ProyectoMultiagentes/openPMA/imagenes/DDMR_bottom.JPG

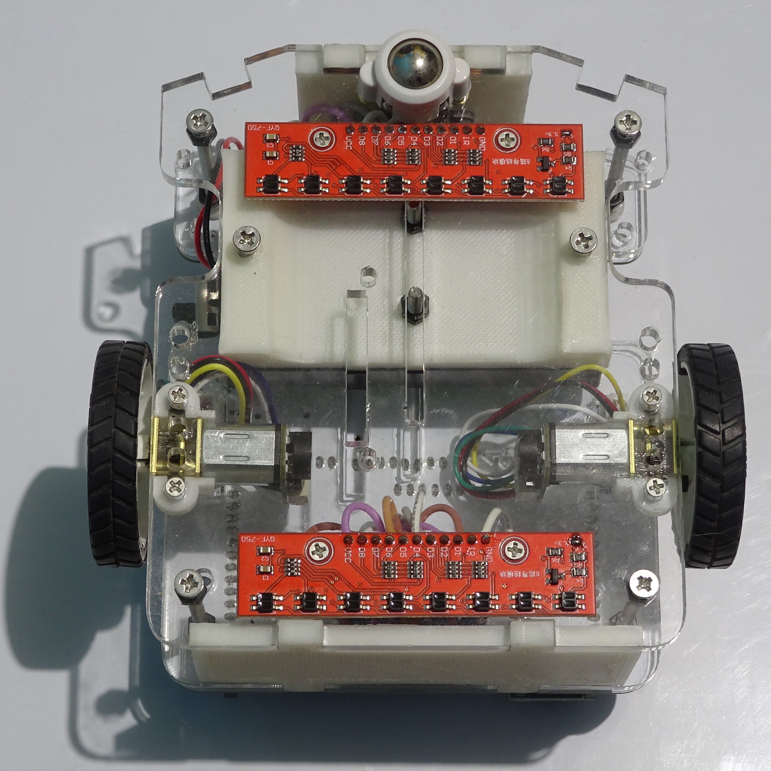
imagenes/DDMR_bottom.JPG
