ProyectoMultiagentes/openPMA/imagenes/DDMR_CAD.png

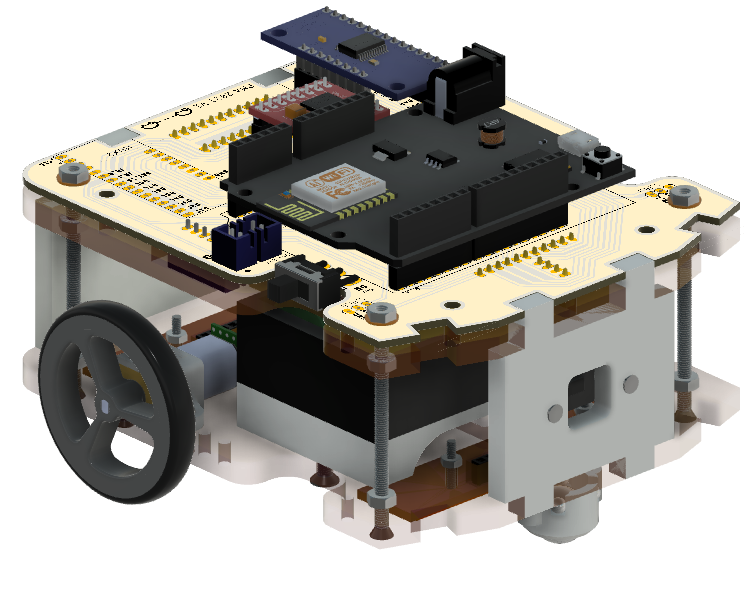
imagenes/DDMR_CAD.png
