ProyectoMultiagentes/openPMA/imagenes/DDMR_top.JPG

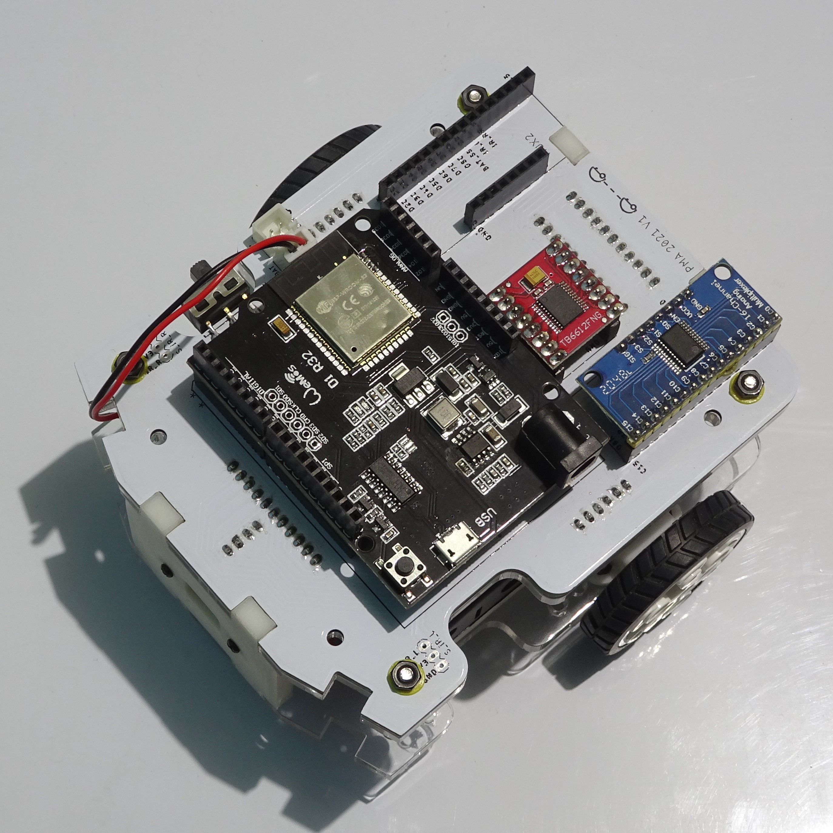
imagenes/DDMR_top.JPG
