ProyectoMultiagentes/openPMA/imagenes/diagrama_de_conexiones_robot.png

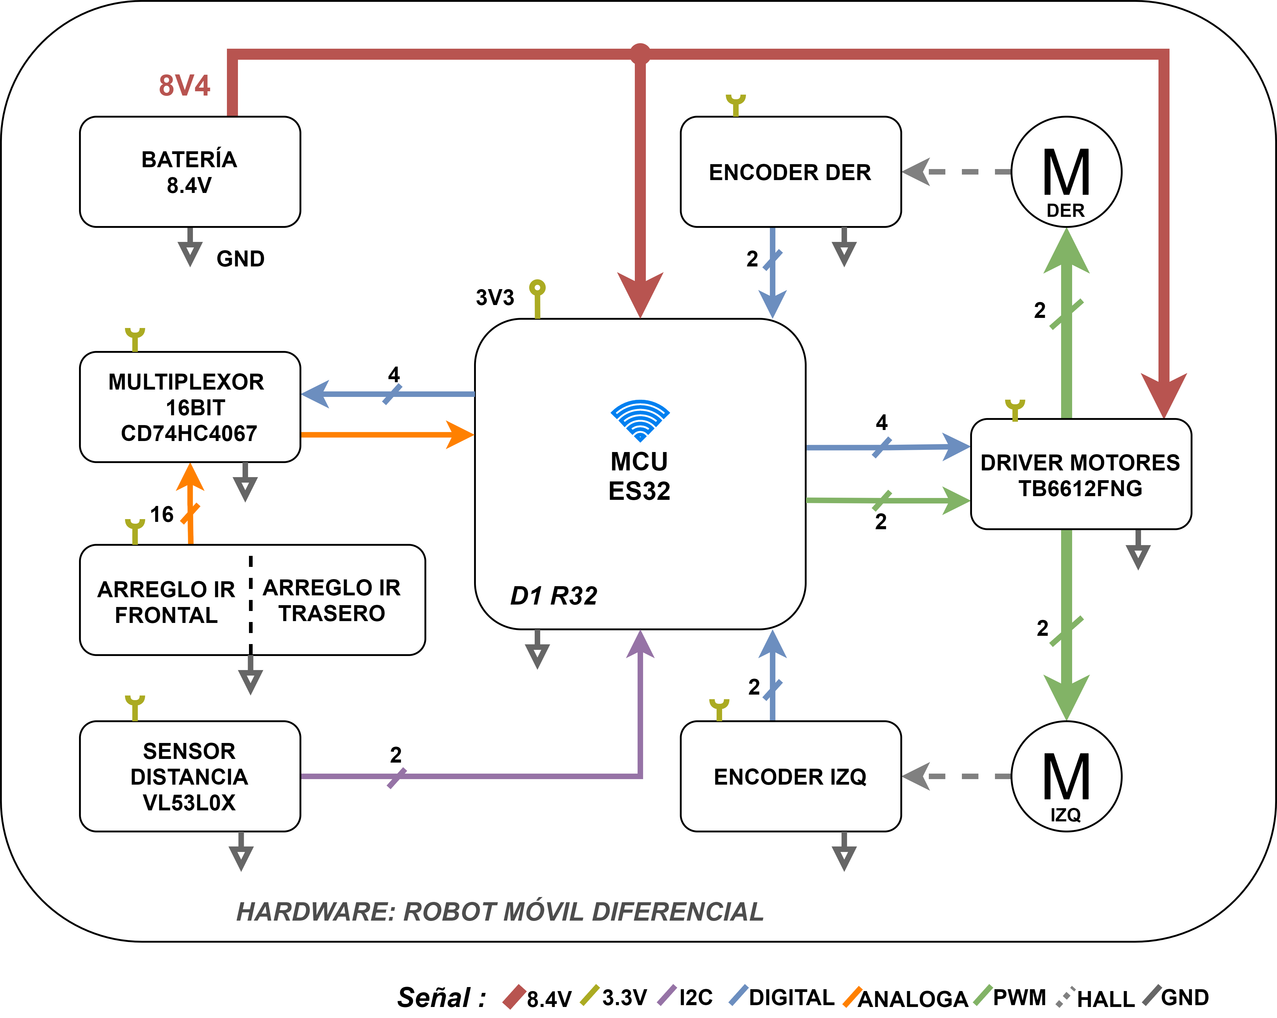
imagenes/diagrama_de_conexiones_robot.png
