ProyectoMultiagentes/openPMA/imagenes/modulos_goma_eva.JPG

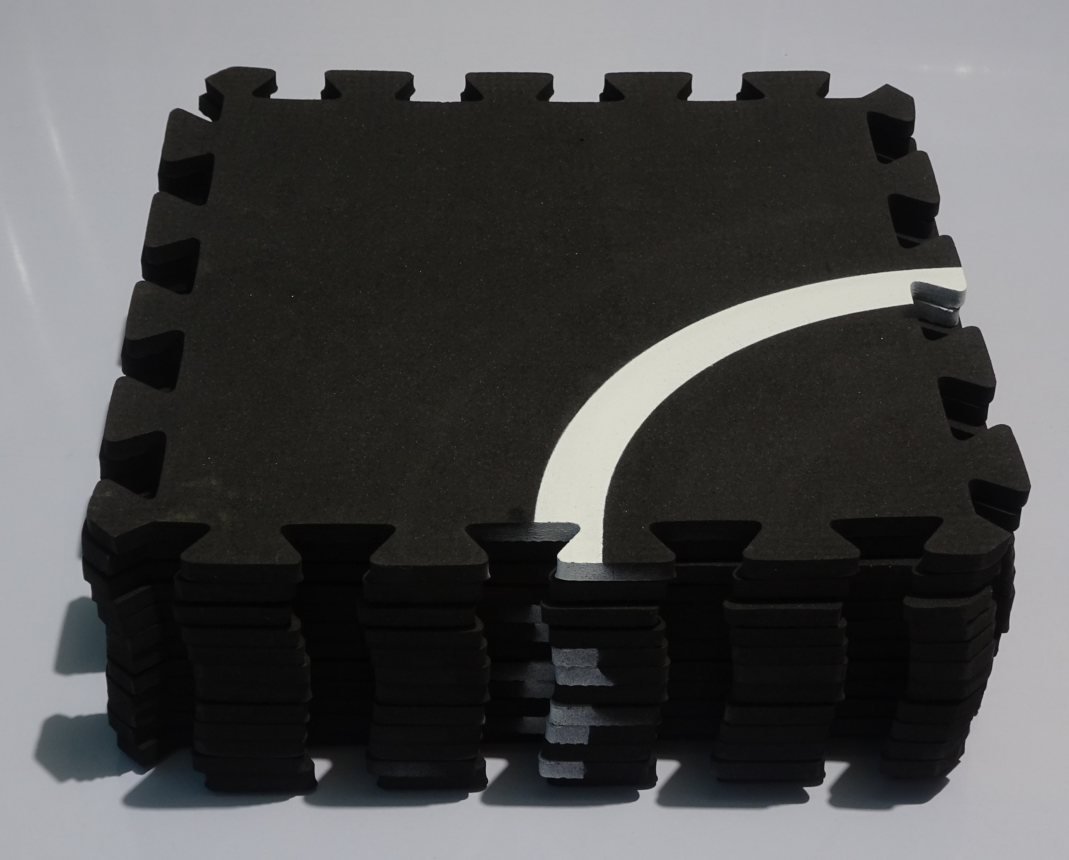
imagenes/modulos_goma_eva.JPG
