ProyectoMultiagentes/openPMA/imagenes/modulos_pista.JPG

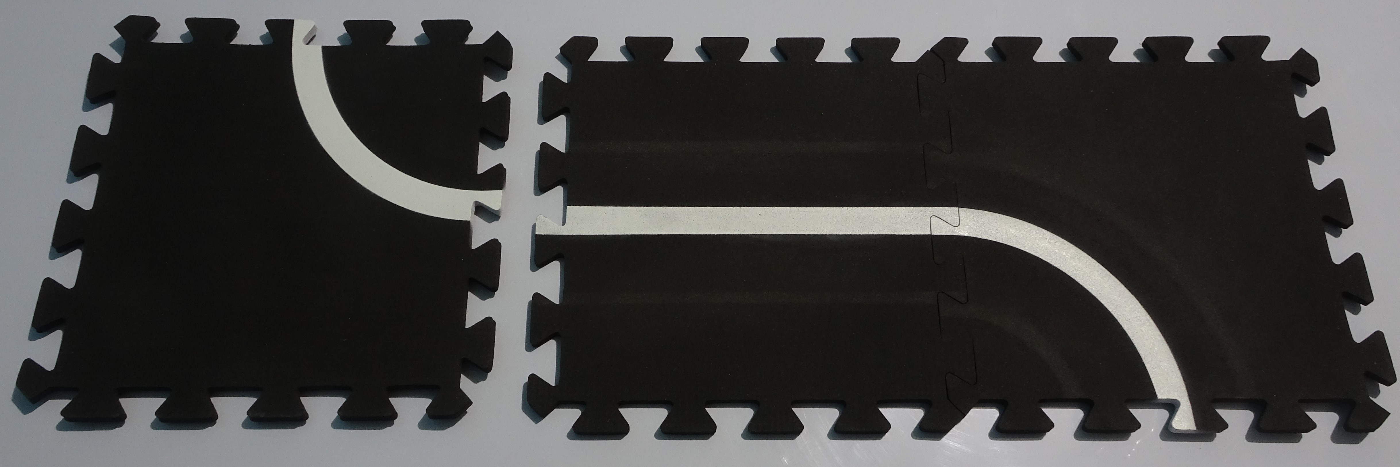
imagenes/modulos_pista.JPG
