ProyectoMultiagentes/openPMA/imagenes/openPMA_topologia_red.png

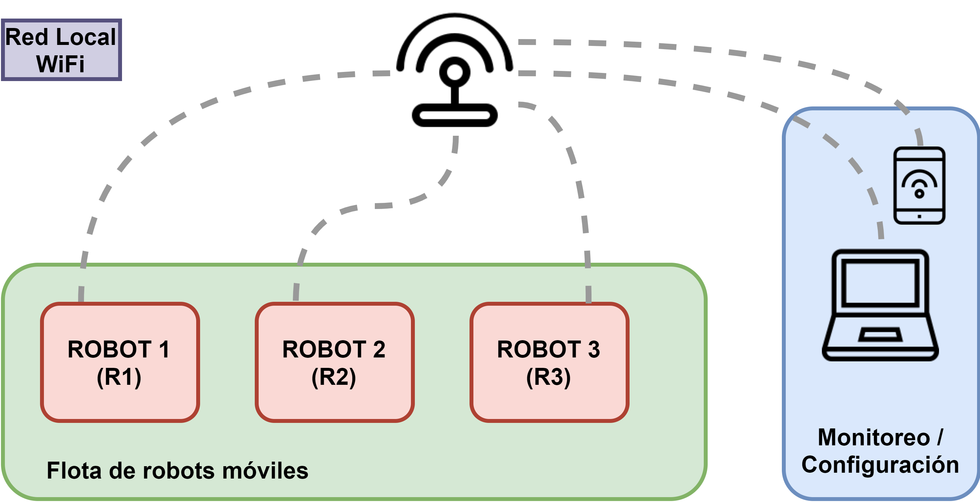
imagenes/openPMA_topologia_red.png
