ProyectoMultiagentes/openPMA/imagenes/PCB_DDMR_bottom.png

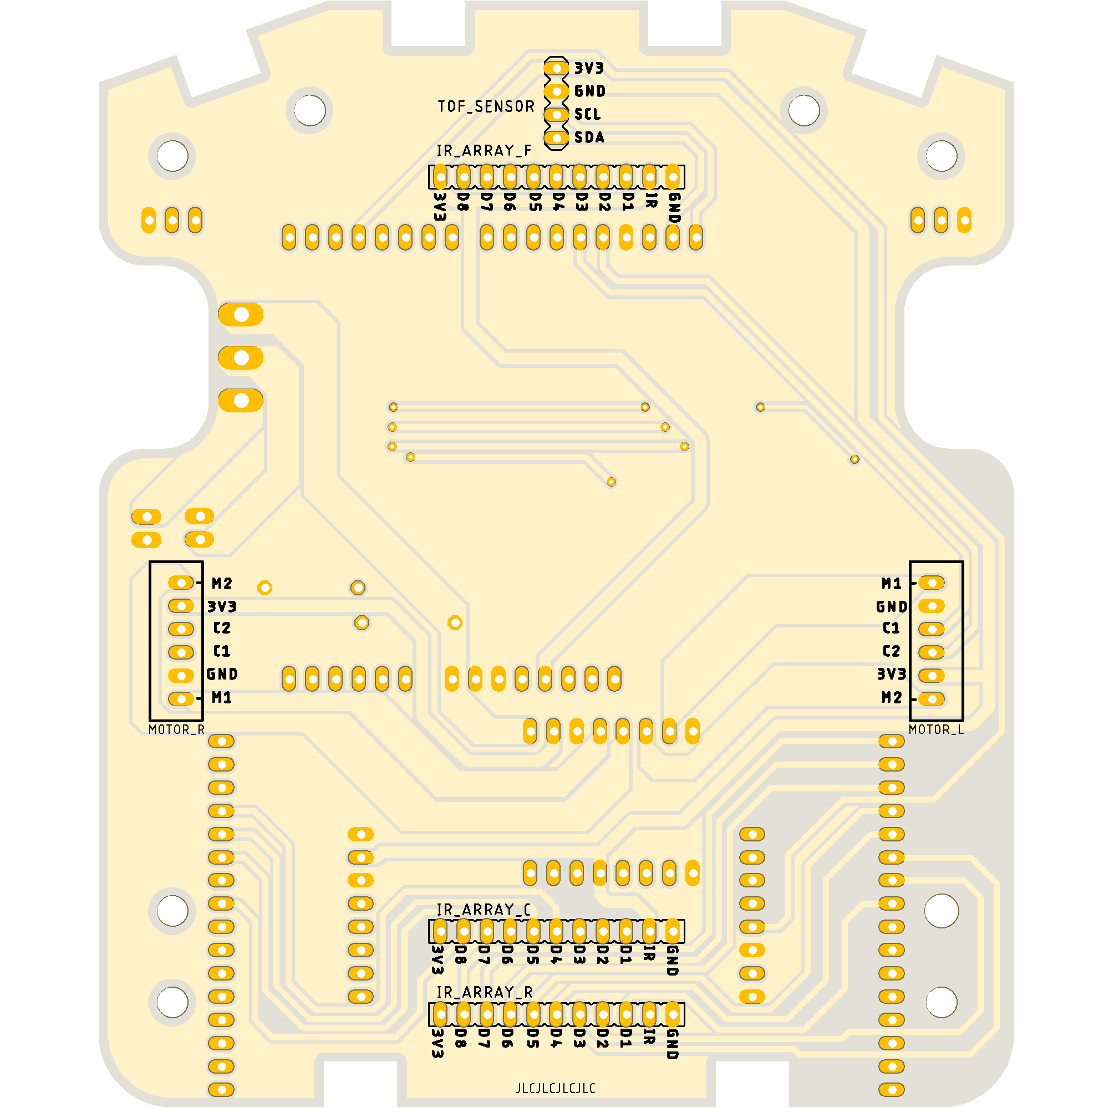
imagenes/PCB_DDMR_bottom.png
