ProyectoMultiagentes/openPMA/imagenes/PCB_DDMR_top.png

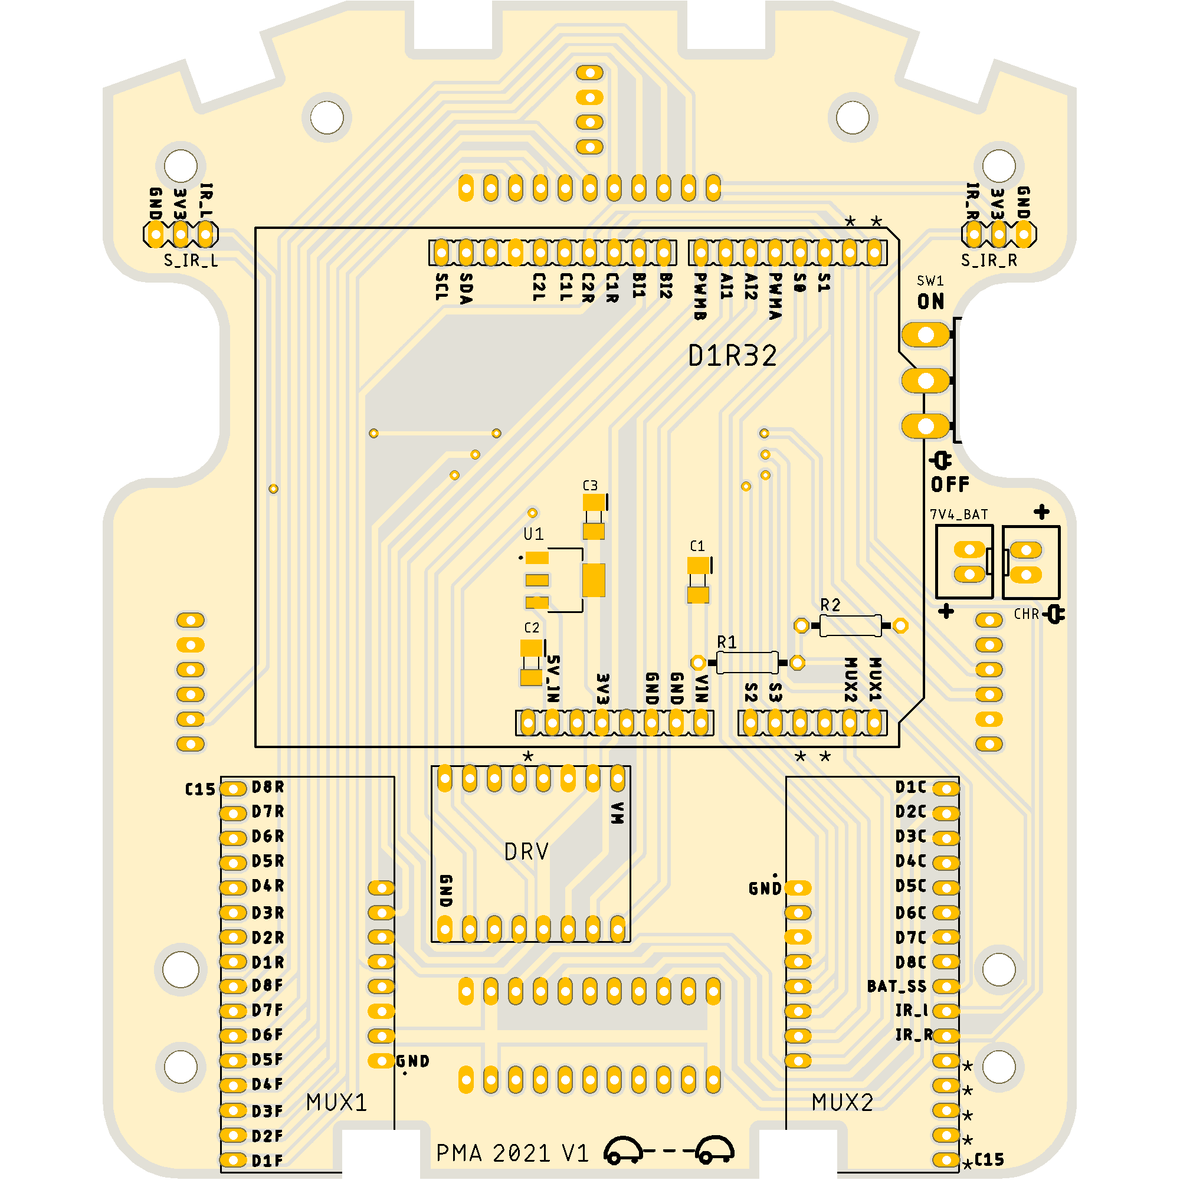
imagenes/PCB_DDMR_top.png
