ProyectoMultiagentes/openPMA/imagenes/robots.JPG

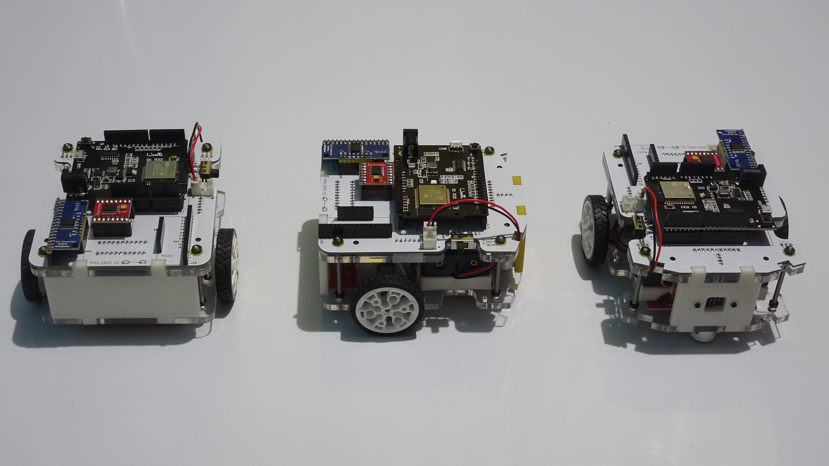
imagenes/robots.JPG
