ProyectoMultiagentes/openPMA/pruebaUDP/prueba.xlsx

Robot,Input_d,d_ref,vel_ref,Input_vel,Input_theta,Output_d,Output_vel,Output_theta
T,48.30,10.00,0.00,0.00,0.13,0.00,0.00,0.00
T,51.00,10.00,0.00,0.00,0.08,0.00,0.00,0.00
T,51.00,10.00,0.00,0.00,0.13,0.00,0.00,0.00
T,50.10,10.00,0.00,0.00,0.09,0.00,0.00,0.00
T,48.00,10.00,0.00,0.00,0.10,0.00,0.00,0.00
T,49.20,10.00,0.00,0.00,0.12,0.00,0.00,0.00
T,49.60,10.00,0.00,0.00,0.10,0.00,0.00,0.00
T,47.60,10.00,0.00,0.00,0.11,0.00,0.00,0.00
T,49.20,10.00,0.00,0.00,0.11,0.00,0.00,0.00
T,47.50,10.00,0.00,0.00,0.10,0.00,0.00,0.00
T,51.40,10.00,0.00,0.00,0.30,0.00,0.00,0.00
T,53.50,10.00,0.00,0.00,0.10,0.00,0.00,0.00
T,47.80,10.00,0.00,0.00,0.12,0.00,0.00,0.00
T,48.70,10.00,0.00,0.00,0.13,0.00,0.00,0.00
T,48.10,10.00,0.00,0.00,0.07,0.00,0.00,0.00
T,50.70,10.00,0.00,0.00,0.20,0.00,0.00,0.00
T,47.80,10.00,0.00,0.00,0.07,0.00,0.00,0.00
T,51.60,10.00,0.00,0.00,0.13,0.00,0.00,0.00
T,50.00,10.00,0.00,0.00,0.12,0.00,0.00,0.00
T,48.30,10.00,0.00,0.00,0.10,0.00,0.00,0.00
T,48.10,10.00,0.00,0.00,0.08,0.00,0.00,0.00
T,49.60,10.00,0.00,0.00,0.09,0.00,0.00,0.00
T,49.50,10.00,0.00,0.00,0.10,0.00,0.00,0.00
T,47.30,10.00,0.00,0.00,0.16,0.00,0.00,0.00
T,48.70,10.00,0.00,0.00,0.10,0.00,0.00,0.00
T,47.60,10.00,0.00,0.00,0.14,0.00,0.00,0.00
T,48.60,10.00,0.00,0.00,0.10,0.00,0.00,0.00
T,50.40,10.00,0.00,0.00,0.07,0.00,0.00,0.00
T,50.90,10.00,0.00,0.00,0.07,0.00,0.00,0.00
T,47.00,10.00,0.00,0.00,0.08,0.00,0.00,0.00
T,48.80,10.00,0.00,0.00,0.10,0.00,0.00,0.00
T,49.90,10.00,0.00,0.00,0.09,0.00,0.00,0.00
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
T,40.70,10.00,0.00,0.00,-0.60,0.00,0.00,0.00
T,40.50,10.00,0.00,0.00,-0.62,0.00,0.00,0.00
T,40.20,10.00,0.00,0.00,-0.62,0.00,0.00,0.00
T,42.20,10.00,0.00,0.00,-0.82,0.00,0.00,0.00
T,42.10,10.00,0.00,0.00,-0.60,0.00,0.00,0.00
T,42.10,10.00,0.00,0.00,-0.57,0.00,0.00,0.00
