ProyectoMultiagentes/openPMA/pruebaUDP/pruebas_actualizadas.xlsx

Robot | Input_d | d_ref | vel_ref | Input_vel | Input_theta | Output_d | Output_vel | Output_theta
T | 33.1 | 10 | 0 | 0 | 0.86 | 0 | 0 | 0
T | 33.8 | 10 | 0 | 0 | 0.86 | 0 | 0 | 0
T | 34.2 | 10 | 0 | 0 | 0.88 | 0 | 0 | 0
T | 34.2 | 10 | 0 | 0 | 0.88 | 0 | 0 | 0
T | 34 | 10 | 0 | 0 | 0.92 | 0 | 0 | 0
T | 34.6 | 10 | 0 | 0 | 0.88 | 0 | 0 | 0
T | 33.5 | 10 | 0 | 0 | 0.85 | 0 | 0 | 0
T | 34.5 | 10 | 0 | 0 | 0.67 | 0 | 0 | 0
T | 33.8 | 10 | 0 | 0 | 0.88 | 0 | 0 | 0
T | 34.8 | 10 | 0 | 0 | 0.84 | 0 | 0 | 0
T | 34.3 | 10 | 0 | 0 | 0.87 | 0 | 0 | 0
T | 33.2 | 10 | 0 | 0 | 0.88 | 0 | 0 | 0
T | 33.3 | 10 | 0 | 0 | 0.86 | 0 | 0 | 0
T | 33.9 | 10 | 0 | 0 | 0.87 | 0 | 0 | 0
T | 33.6 | 10 | 0 | 0 | 0.89 | 0 | 0 | 0
T | 33.9 | 10 | 0 | 0 | 0.92 | 0 | 0 | 0
T | 34.1 | 10 | 0 | 0 | 0.87 | 0 | 0 | 0
T | 34.2 | 10 | 0 | 0 | 0.87 | 0 | 0 | 0
T | 33.8 | 10 | 0 | 0 | 0.91 | 0 | 0 | 0
T | 33.9 | 10 | 0 | 0 | 0.86 | 0 | 0 | 0
T | 33.7 | 10 | 0 | 0 | 0.9 | 0 | 0 | 0
T | 34.2 | 10 | 0 | 0 | 0.9 | 0 | 0 | 0
T | 34.5 | 10 | 0 | 0 | 0.86 | 0 | 0 | 0
T | 34.9 | 10 | 0 | 0 | 0.86 | 0 | 0 | 0
T | 34.8 | 10 | 0 | 0 | 0.84 | 0 | 0 | 0
T | 33.7 | 10 | 0 | 0 | 0.88 | 0 | 0 | 0
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
