ProyectoMultiagentes/openPMA/pruebaUDP/pruebas_actualizadas_2.xlsx

Robot | Input_d | d_ref | vel_ref | Input_vel | Input_theta | Output_d | Output_vel | Output_theta
T | 48.3 | 10 | 0 | 0 | 0.13 | 0 | 0 | 0
T | 51 | 10 | 0 | 0 | 0.08 | 0 | 0 | 0
T | 51 | 10 | 0 | 0 | 0.13 | 0 | 0 | 0
T | 50.1 | 10 | 0 | 0 | 0.09 | 0 | 0 | 0
T | 48 | 10 | 0 | 0 | 0.1 | 0 | 0 | 0
T | 49.2 | 10 | 0 | 0 | 0.12 | 0 | 0 | 0
T | 49.6 | 10 | 0 | 0 | 0.1 | 0 | 0 | 0
T | 47.6 | 10 | 0 | 0 | 0.11 | 0 | 0 | 0
T | 49.2 | 10 | 0 | 0 | 0.11 | 0 | 0 | 0
T | 47.5 | 10 | 0 | 0 | 0.1 | 0 | 0 | 0
T | 51.4 | 10 | 0 | 0 | 0.3 | 0 | 0 | 0
T | 53.5 | 10 | 0 | 0 | 0.1 | 0 | 0 | 0
T | 47.8 | 10 | 0 | 0 | 0.12 | 0 | 0 | 0
T | 48.7 | 10 | 0 | 0 | 0.13 | 0 | 0 | 0
T | 48.1 | 10 | 0 | 0 | 0.07 | 0 | 0 | 0
T | 50.7 | 10 | 0 | 0 | 0.2 | 0 | 0 | 0
T | 47.8 | 10 | 0 | 0 | 0.07 | 0 | 0 | 0
T | 51.6 | 10 | 0 | 0 | 0.13 | 0 | 0 | 0
T | 50 | 10 | 0 | 0 | 0.12 | 0 | 0 | 0
T | 48.3 | 10 | 0 | 0 | 0.1 | 0 | 0 | 0
T | 48.1 | 10 | 0 | 0 | 0.08 | 0 | 0 | 0
T | 49.6 | 10 | 0 | 0 | 0.09 | 0 | 0 | 0
T | 49.5 | 10 | 0 | 0 | 0.1 | 0 | 0 | 0
T | 47.3 | 10 | 0 | 0 | 0.16 | 0 | 0 | 0
T | 48.7 | 10 | 0 | 0 | 0.1 | 0 | 0 | 0
T | 47.6 | 10 | 0 | 0 | 0.14 | 0 | 0 | 0
T | 48.6 | 10 | 0 | 0 | 0.1 | 0 | 0 | 0
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
