ProyectoMultiagentes/openPMA/pruebaUDP/monitoreo.csv

Robot | Delta_muestra | Input_d | d_ref | vel_ref | Input_vel | Input_theta | Output_d | Output_vel | Output_theta | curva | alpha_fuzzy | radio_curva
S | 40 | 13.00 | 13.10 | 0.12 | 0.00 | 0.00 | 0.00 | 0.00 | 0.00 | 0.00 | 0.99 | 0.01
L | 40 | 28.30 | 24.90 | 0.00 | 0.59 | 0.03 | 0.00 | -13.51 | -43.69 | 2.18 | 0.99 | 0.19
L | 40 | 24.00 | 24.90 | 0.00 | 0.07 | 0.03 | 0.00 | -1.92 | -92.07 | 1.85 | 0.99 | 0.19
S | 40 | 13.20 | 13.10 | 0.12 | 0.00 | 0.00 | 0.00 | 0.00 | 0.00 | 0.00 | 0.99 | 0.01
S | 40 | 13.20 | 13.10 | 0.12 | 0.00 | 0.00 | 0.00 | 0.00 | 0.00 | 0.00 | 0.99 | 0.01
L | 40 | 26.50 | 24.90 | 0.00 | 0.05 | 0.03 | 0.00 | -1.43 | -96.57 | 1.16 | 0.99 | 0.19
L | 40 | 28.20 | 24.90 | 0.00 | 0.04 | 0.03 | 0.00 | -0.99 | -98.93 | 0.71 | 0.99 | 0.19
S | 40 | 13.20 | 13.10 | 0.12 | 0.00 | 0.00 | 0.00 | 0.00 | 0.00 | 0.00 | 0.99 | 0.01
L | 40 | 28.10 | 24.90 | 0.00 | -0.01 | 0.02 | 0.00 | 0.17 | -91.86 | 0.82 | 0.99 | 0.19
S | 40 | 13.40 | 13.10 | 0.12 | 0.00 | -0.00 | 0.00 | 0.00 | 0.00 | 0.00 | 0.99 | 0.01
S | 40 | 13.40 | 13.10 | 0.12 | 0.00 | 0.00 | 0.00 | 0.00 | 0.00 | 0.00 | 0.99 | 0.01
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
