ProyectoMultiagentes/openPMA/pruebaUDP/Matplotlib_en_Tkinter-lvrfuz/control_Motor_Lectura_RPM_Python.png

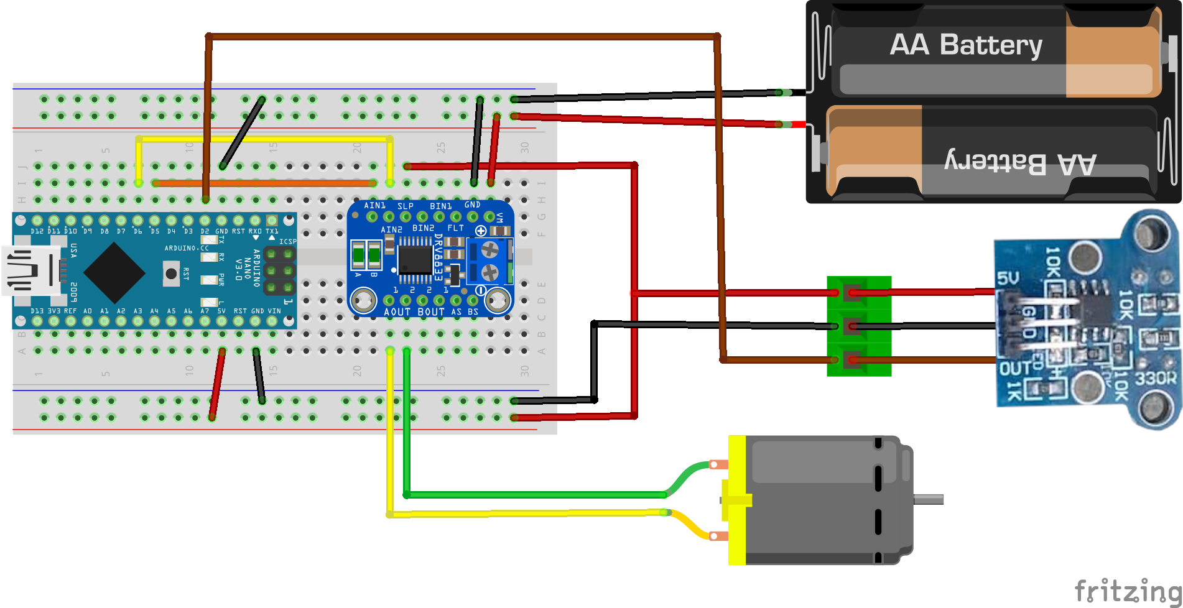
pruebaUDP/Matplotlib_en_Tkinter-lvrfuz/control_Motor_Lectura_RPM_Python.png
