ProyectoMultiagentes/openPMA/Archivos_PCB/esquematico_DDMR_openPMA.pdf

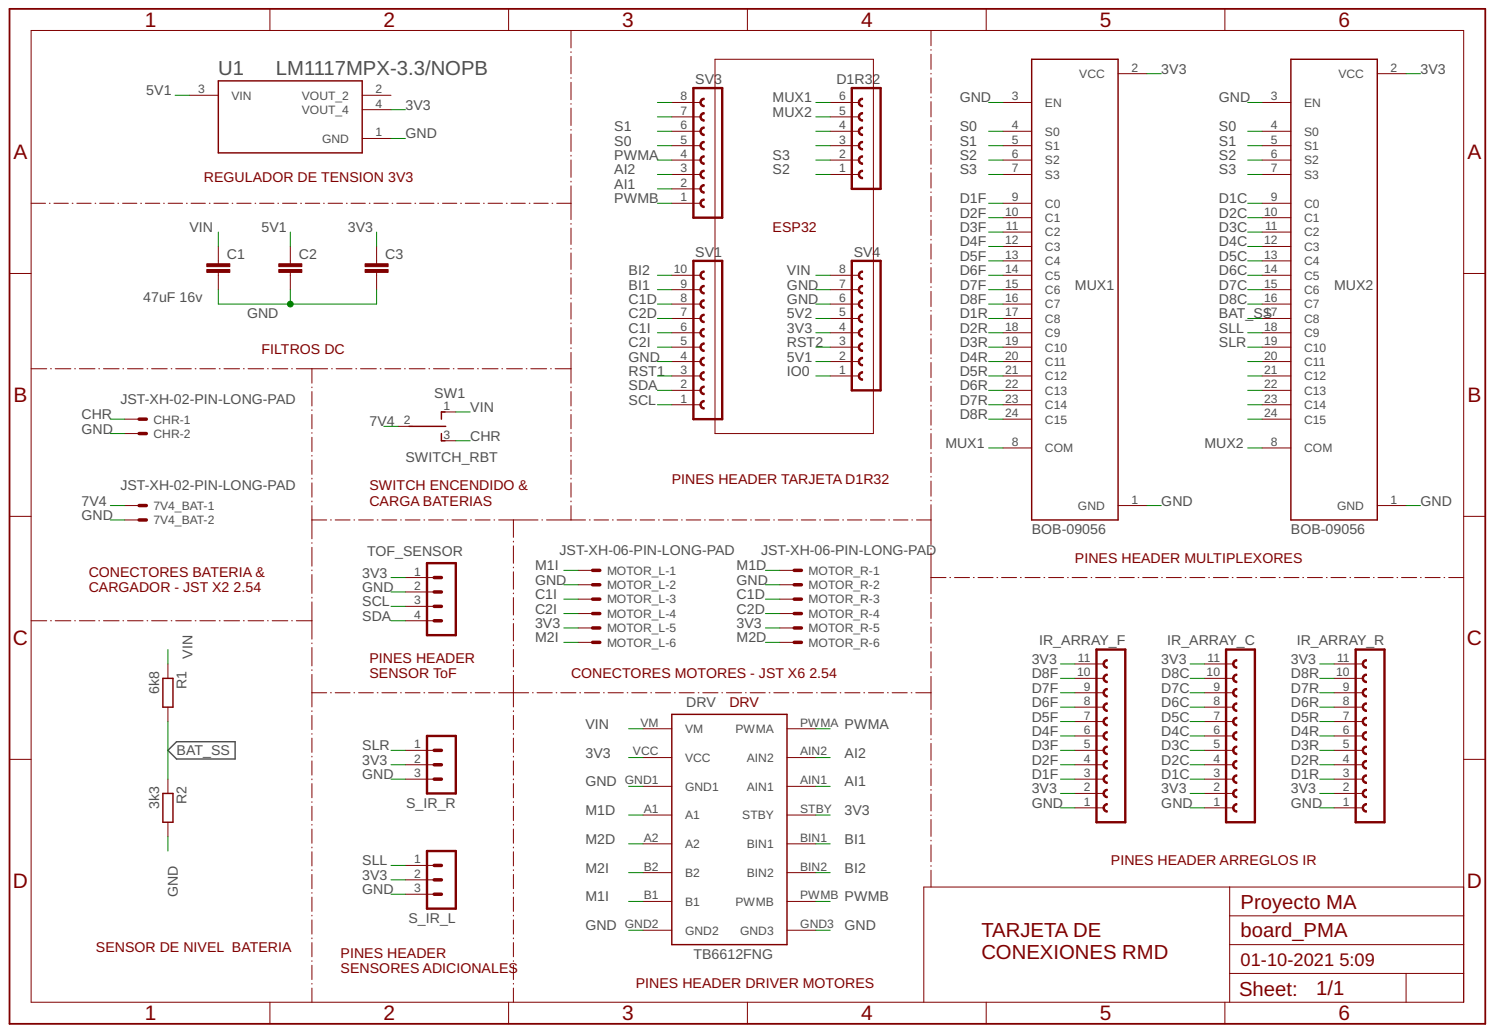
[picture p15: page 1]

JST-XH-02-PIN-LONG-PAD
CHR
GND

PINES HEADER ARREGLOS IR

PINES HEADER DRIVER MOTORES
