ProyectoMultiagentes/openPMA/Archivos_PCB/archivos_EAGLE/Proyecto_MA/board_PMA.brd

## EAGLE design Archivos_PCB/archivos_EAGLE/Proyecto_MA/board_PMA.brd (2022-01-05)

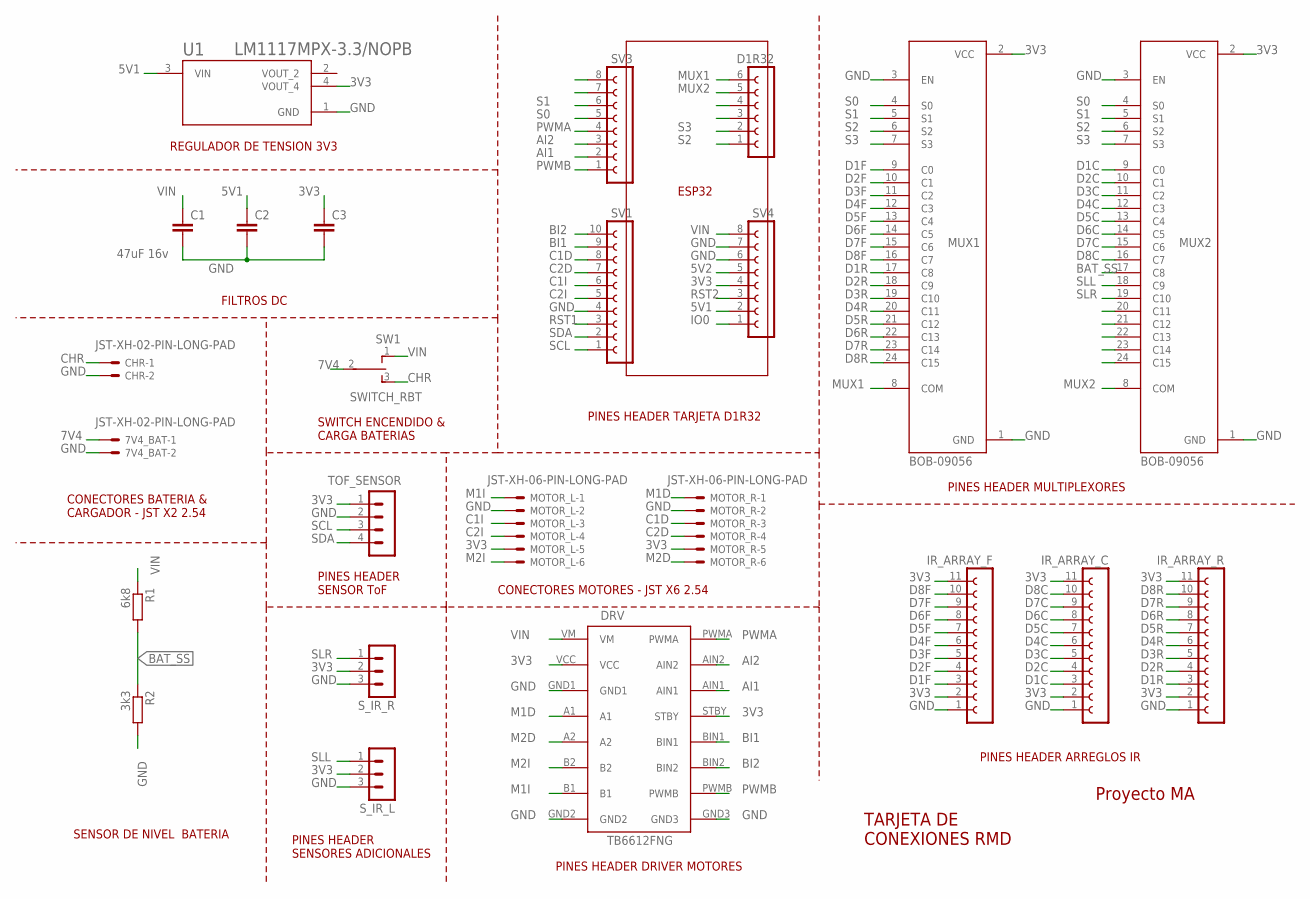
[picture p16: schematic board_PMA.sch]

Parts:
7V4_BAT: JST-XH-02-PIN-LONG-PAD; JST-XH-02-PACKAGE-LONG-PAD
C1: 47uF 16v; C1206K
C2, C3: C-EUC1206K; C1206K
CHR: JST-XH-02-PIN-LONG-PAD; JST-XH-02-PACKAGE-LONG-PAD
D1R32: FE06-1; FE06
DRV: TB6612FNG
IR_ARRAY_C: FE11-1; FE11
IR_ARRAY_F: FE11-1; FE11
IR_ARRAY_R: FE11-1; FE11
MOTOR_L: JST-XH-06-PIN-LONG-PAD; JST-XH-06-PACKAGE-LONG-PAD
MOTOR_R: JST-XH-06-PIN-LONG-PAD; JST-XH-06-PACKAGE-LONG-PAD
MUX1, MUX2: BOB-09056; XDCR_BOB-09056
R1: 6k8; 0207/10
R2: 3k3; 0207/10
SV1: FE10-1; FE10
SV3, SV4: FE08-1; FE08
SW1: SWITCH_RBT; SW
S_IR_L: MA03-1
S_IR_R: MA03-1
TOF_SENSOR: MA04-1
U1: LM1117MPX-3.3/NOPB; VREG_LM1117MPX-3.3/NOPB

Connections:
3V3: C3.1, DRV.STBY, DRV.VCC, IR_ARRAY_C.2, IR_ARRAY_C.11, IR_ARRAY_F.2, IR_ARRAY_F.11, IR_ARRAY_R.2, IR_ARRAY_R.11, MOTOR_L.5, MOTOR_R.5, MUX1.2 (VCC), MUX2.2 (VCC), SV4.4, S_IR_L.2, S_IR_R.2, TOF_SENSOR.1, U1.4 (VOUT_4)
5V1: C2.1, SV4.2, U1.3 (VIN)
5V2: SV4.5
7V4: 7V4_BAT.1, SW1.2
AI1: DRV.AIN1, SV3.2
AI2: DRV.AIN2, SV3.3
BAT_SS: MUX2.17 (C8), R1.2, R2.1
BI1: DRV.BIN1, SV1.9
BI2: DRV.BIN2, SV1.10
C1D: MOTOR_R.3, SV1.8
C1I: MOTOR_L.3, SV1.6
C2D: MOTOR_R.4, SV1.7
C2I: MOTOR_L.4, SV1.5
CHR: CHR.1, SW1.3
D1C: IR_ARRAY_C.3, MUX2.9 (C0)
D1F: IR_ARRAY_F.3, MUX1.9 (C0)
D1R: IR_ARRAY_R.3, MUX1.17 (C8)
D2C: IR_ARRAY_C.4, MUX2.10 (C1)
D2F: IR_ARRAY_F.4, MUX1.10 (C1)
D2R: IR_ARRAY_R.4, MUX1.18 (C9)
D3C: IR_ARRAY_C.5, MUX2.11 (C2)
D3F: IR_ARRAY_F.5, MUX1.11 (C2)
D3R: IR_ARRAY_R.5, MUX1.19 (C10)
D4C: IR_ARRAY_C.6, MUX2.12 (C3)
D4F: IR_ARRAY_F.6, MUX1.12 (C3)
D4R: IR_ARRAY_R.6, MUX1.20 (C11)
D5C: IR_ARRAY_C.7, MUX2.13 (C4)
D5F: IR_ARRAY_F.7, MUX1.13 (C4)
D5R: IR_ARRAY_R.7, MUX1.21 (C12)
D6C: IR_ARRAY_C.8, MUX2.14 (C5)
D6F: IR_ARRAY_F.8, MUX1.14 (C5)
D6R: IR_ARRAY_R.8, MUX1.22 (C13)
D7C: IR_ARRAY_C.9, MUX2.15 (C6)
D7F: IR_ARRAY_F.9, MUX1.15 (C6)
D7R: IR_ARRAY_R.9, MUX1.23 (C14)
D8C: IR_ARRAY_C.10, MUX2.16 (C7)
D8F: IR_ARRAY_F.10, MUX1.16 (C7)
D8R: IR_ARRAY_R.10, MUX1.24 (C15)
GND: 7V4_BAT.2, C1.2, C2.2, C3.2, CHR.2, DRV.GND1, DRV.GND2, DRV.GND3, IR_ARRAY_C.1, IR_ARRAY_F.1, IR_ARRAY_R.1, MOTOR_L.2, MOTOR_R.2, MUX1.1 (GND), MUX1.3 (EN), MUX2.1 (GND), MUX2.3 (EN), R2.2, SV1.4, SV4.6, SV4.7, S_IR_L.3, S_IR_R.3, TOF_SENSOR.2, U1.1 (GND)
IO0: SV4.1
M1D: DRV.A1, MOTOR_R.1
M1I: DRV.B1, MOTOR_L.1
M2D: DRV.A2, MOTOR_R.6
M2I: DRV.B2, MOTOR_L.6
MUX1: D1R32.6, MUX1.8 (COM)
MUX2: D1R32.5, MUX2.8 (COM)
PWMA: DRV.PWMA, SV3.4
PWMB: DRV.PWMB, SV3.1
RST1: SV1.3
RST2: SV4.3
S0: MUX1.4 (S0), MUX2.4 (S0), SV3.5
S1: MUX1.5 (S1), MUX2.5 (S1), SV3.6
S2: D1R32.1, MUX1.6 (S2), MUX2.6 (S2)
S3: D1R32.2, MUX1.7 (S3), MUX2.7 (S3)
SCL: SV1.1, TOF_SENSOR.3
SDA: SV1.2, TOF_SENSOR.4
SLL: MUX2.18 (C9), S_IR_L.1
SLR: MUX2.19 (C10), S_IR_R.1
VIN: C1.1, DRV.VM, R1.1, SV4.8, SW1.1

Notes on the sheet:
ESP32
PINES HEADER TARJETA D1R32
REGULADOR DE TENSION 3V3
FILTROS DC
CONECTORES BATERIA & CARGADOR - JST X2 2.54
SENSOR DE NIVEL BATERIA
PINES HEADER SENSORES ADICIONALES
PINES HEADER DRIVER MOTORES
PINES HEADER SENSOR ToF
CONECTORES MOTORES - JST X6 2.54
SWITCH ENCENDIDO & CARGA BATERIAS
PINES HEADER ARREGLOS IR
PINES HEADER MULTIPLEXORES
TARJETA DE CONEXIONES RMD
Proyecto MA

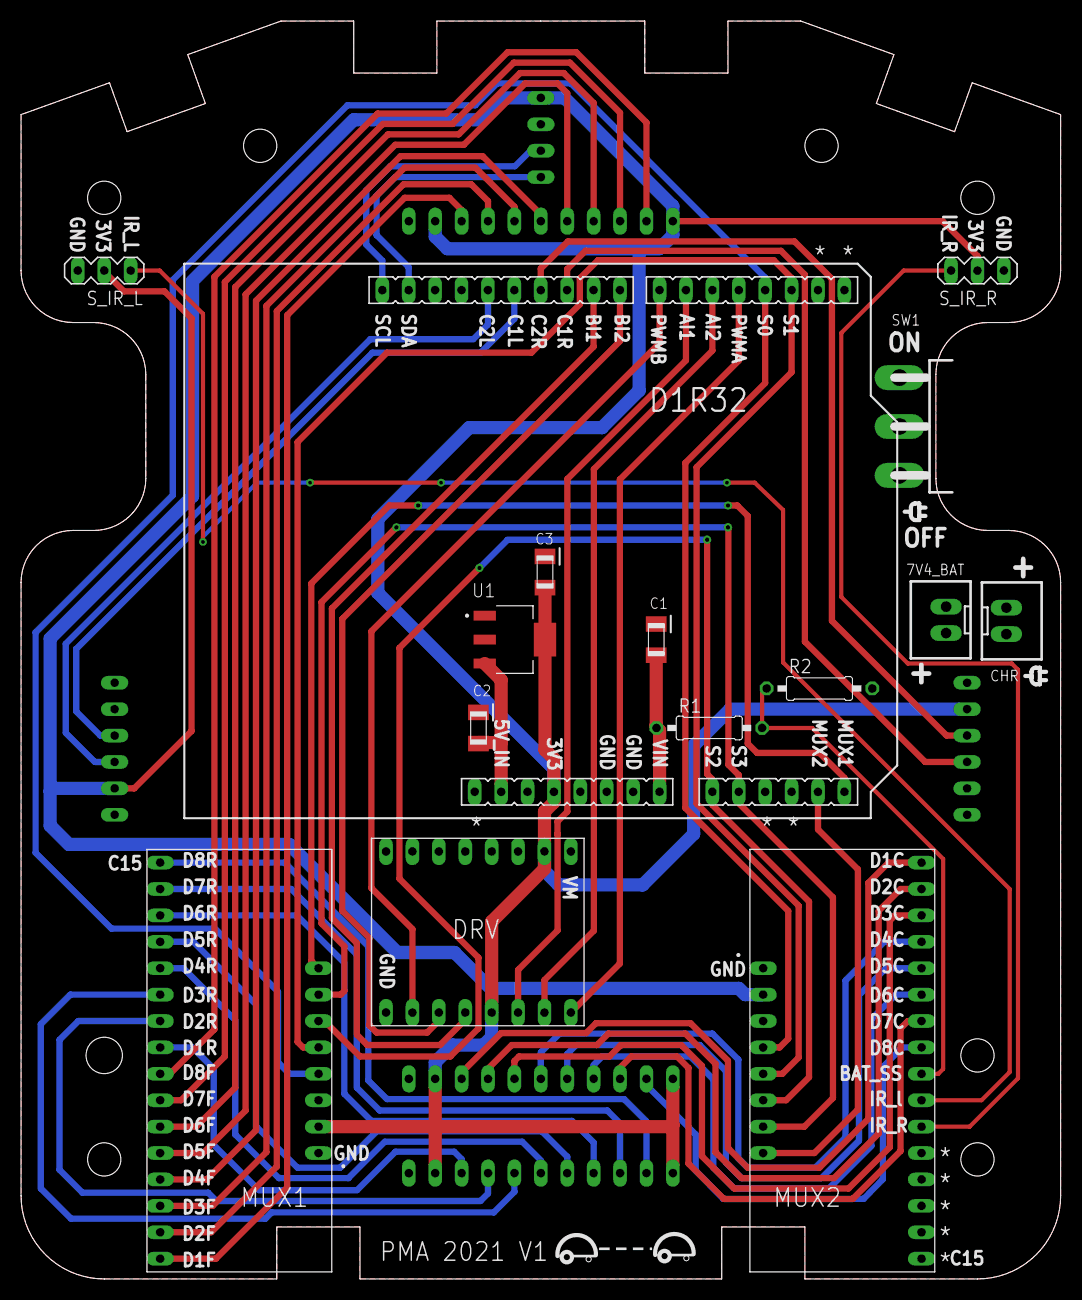
[picture p17: board board_PMA.brd from above]

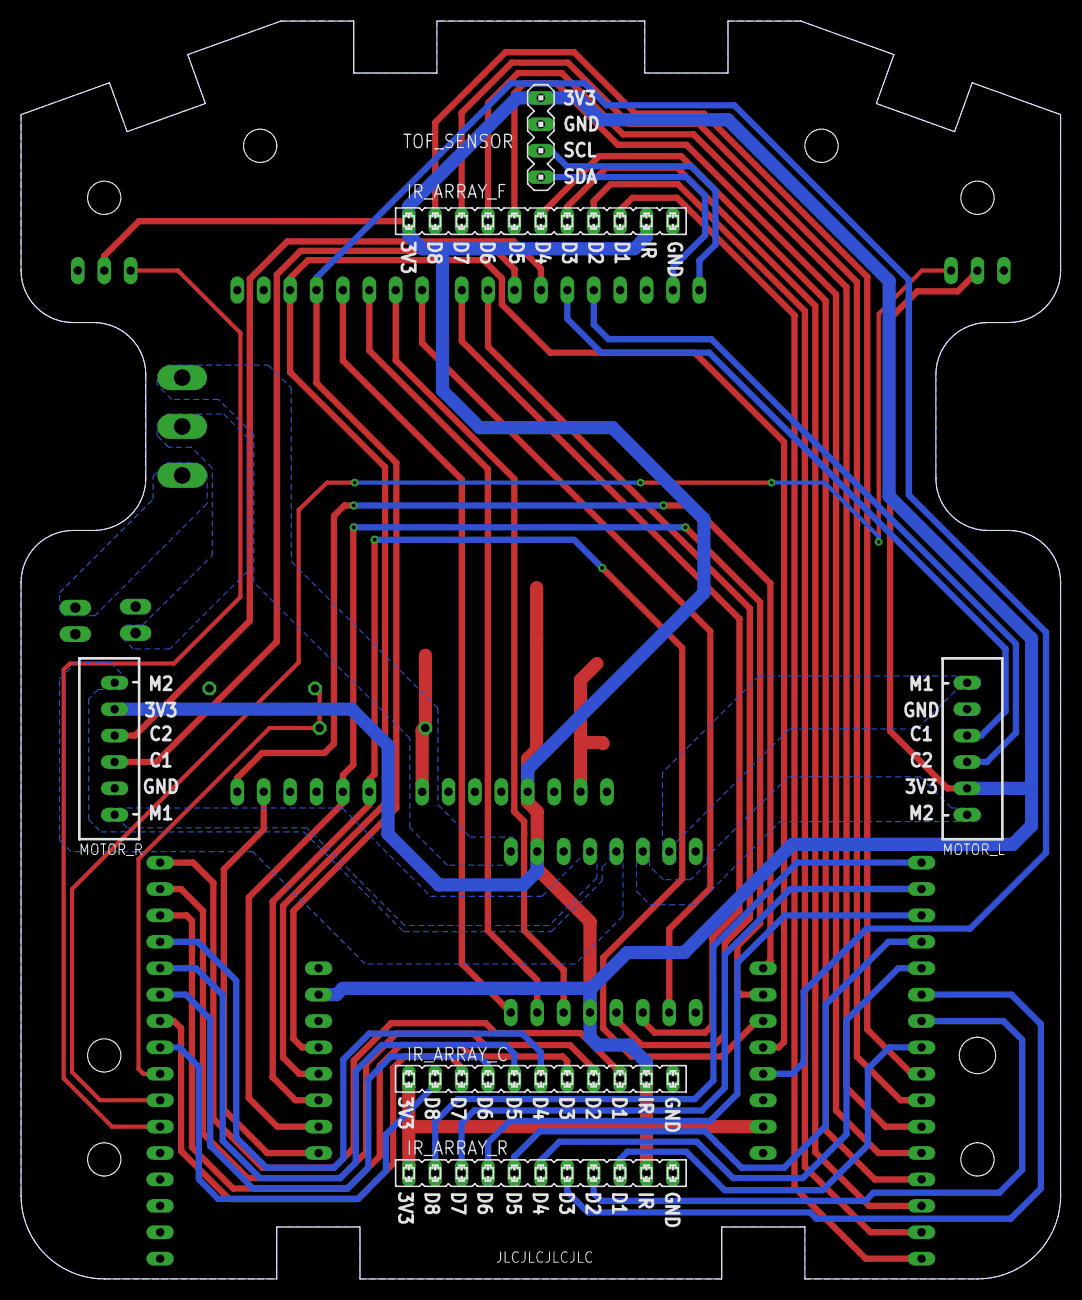
[picture p18: board board_PMA.brd from below]

Board: 2 copper layers, 100.0 x 121.0 mm, 24 parts (2 on the bottom side), 55 nets.
