ProyectoMultiagentes/openPMA/(commit log)

2021-09-12 Subida de códigos de prueba
2021-09-12 Se agrega descripción y comentarios
    Se cambio el nombre de las variables "Velocidad_motor_izq"/"Velocidad_motor_der" por un nombre más apropiado "PWM_motor_izq"/"PWM_motor_der"
2021-12-01 Add files via upload
    se sube código PID
    [monitoreo.csv, prueba.xlsx, pruebas_actualizadas.xlsx, pruebas_actualizadas_2.xlsx]
2022-01-05 Se agregan códigos actualizados
    Códigos actualizados para realizar pruebas a los sensores y actuadores del robot móvil diferencia (DDMR)
2022-01-05 Se agregan codigos de pruebas
    Codigos de pueba actualizados, para los sensores y actuadores del DDMR
